ltomov/4-port-usb-hub/3d-view.png

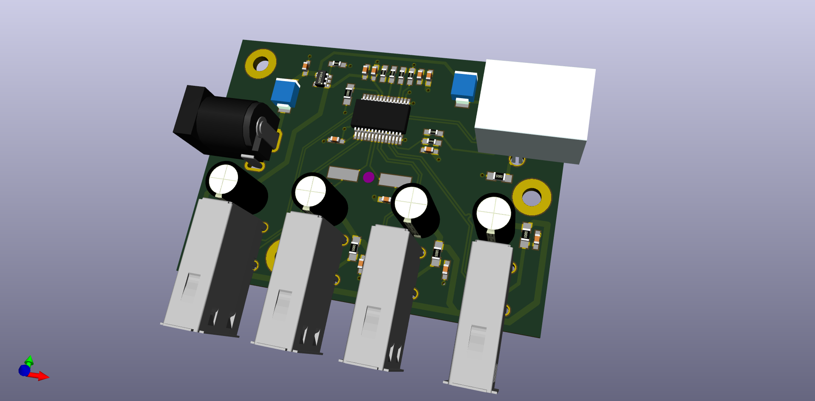
3d-view.png
