ltomov/4-port-usb-hub/4port-usb-hub.pdf

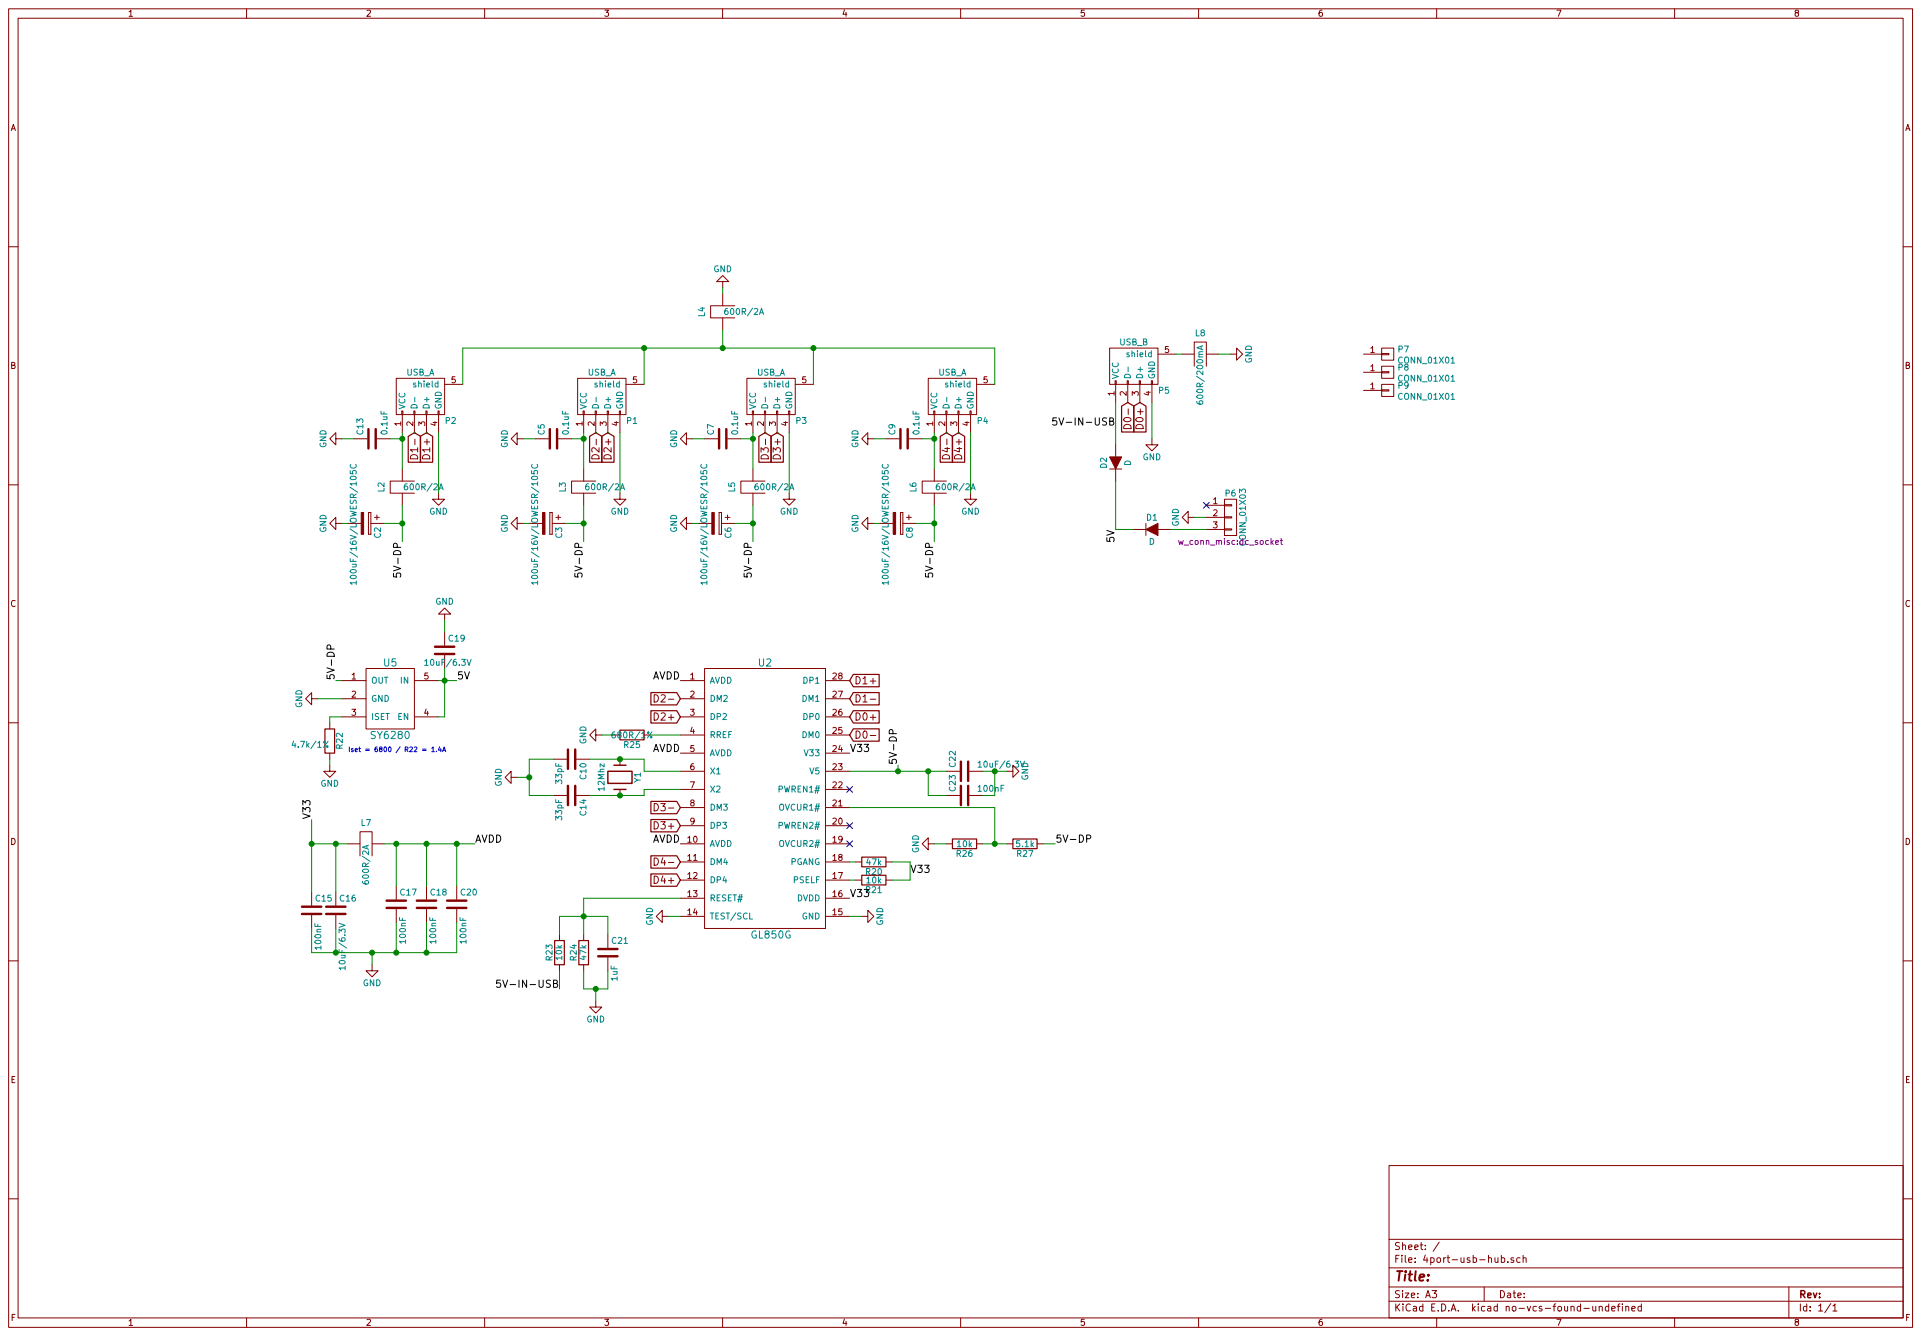
[picture p2: page 1]

3 GND
File: 4port-usb-hub.sch Sheet: / VCC
