ltomov/4-port-usb-hub/4port-usb-hub.kicad_pcb

## KiCad design 4port-usb-hub.kicad_pcb (2016-11-12)

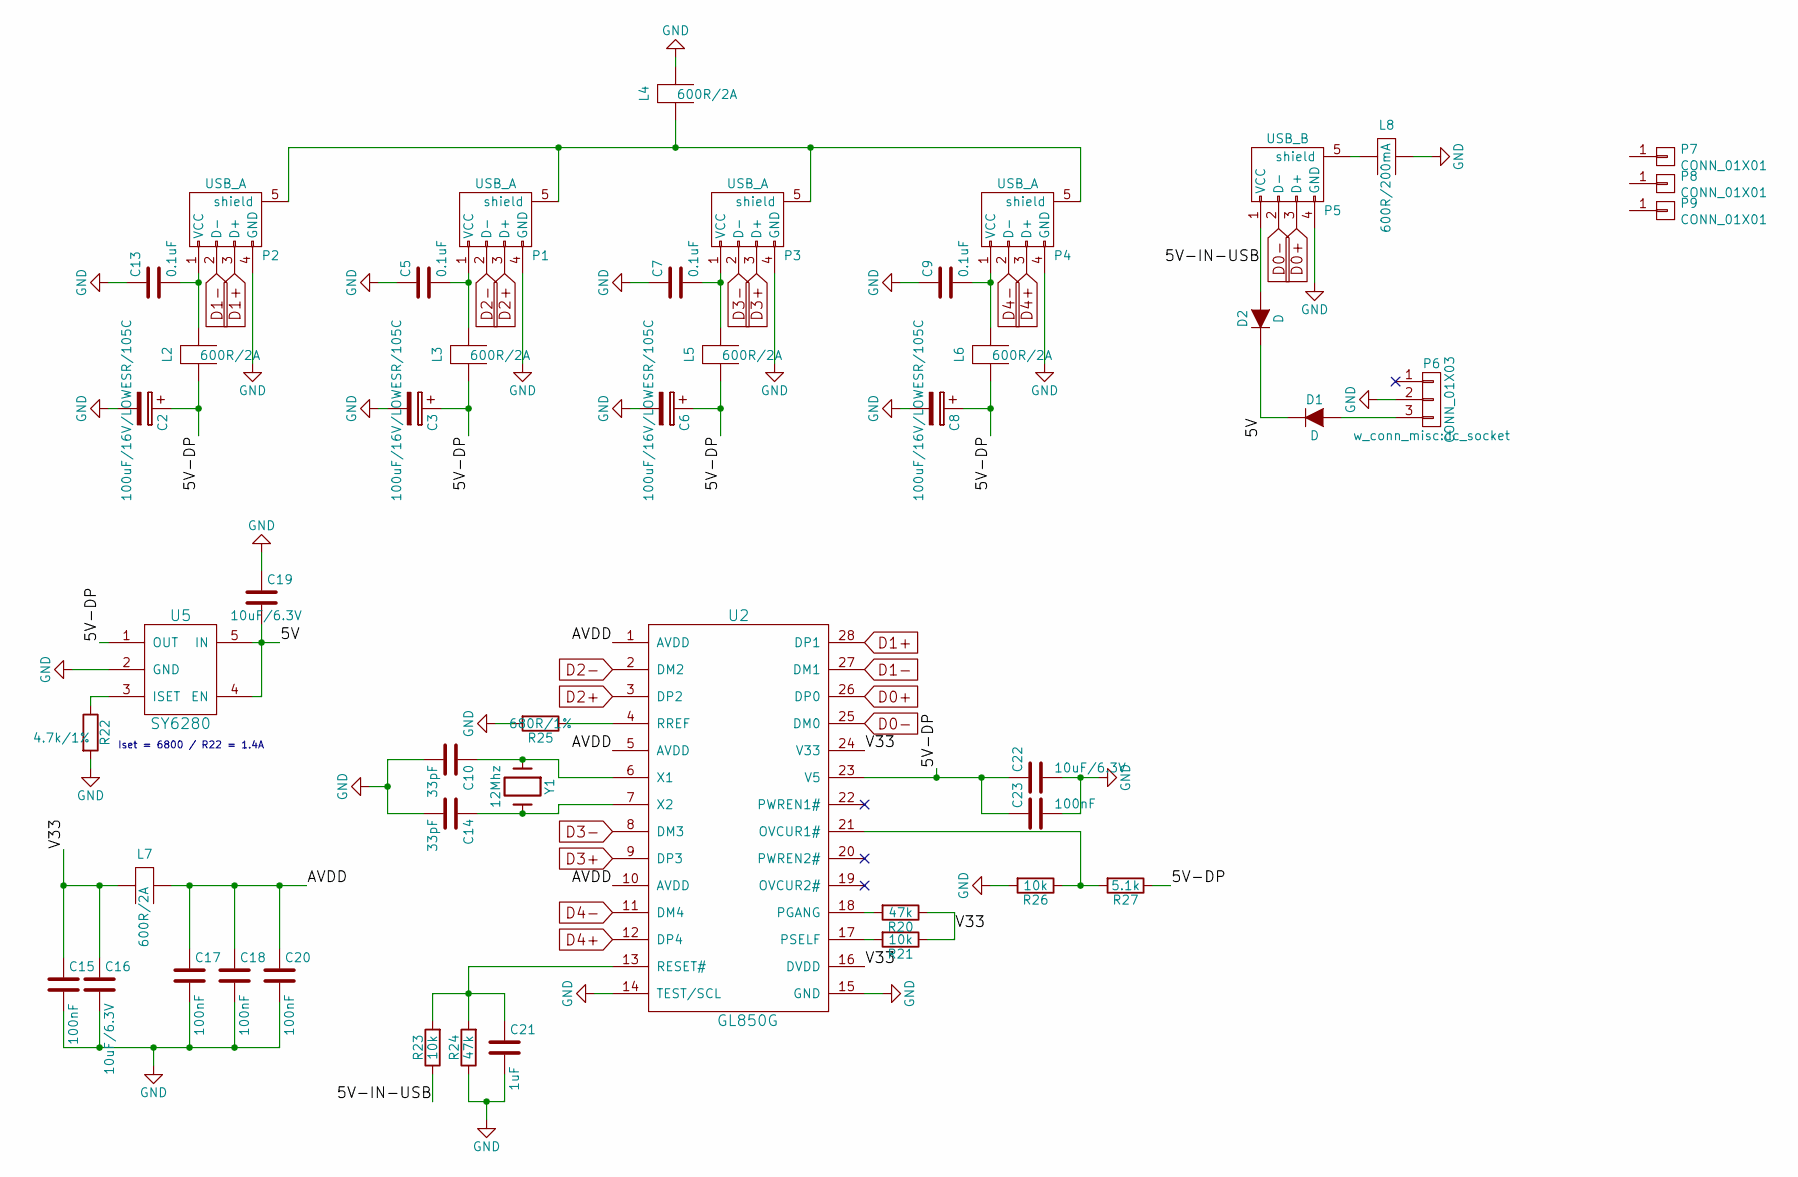
[picture p3: schematic 4port-usb-hub.sch]

Parts:
C2, C3, C6, C8: 100uF/16V/LOWESR/105C; C_Radial_D6.3_L11.2_P2.5
C5, C7, C9, C13: 0.1uF; C_0603_HandSoldering
C10, C14: 33pF; C_0603_HandSoldering
C15, C17, C18, C20, C23: 100nF; C_0603_HandSoldering
C16, C19, C22: 10uF/6.3V; C_0603_HandSoldering
C21: 1uF; C_0603_HandSoldering
D1, D2: D; SMB_Standard
L2, L3, L4, L5, L6, L7: 600R/2A; R_0805_HandSoldering
L8: 600R/200mA; R_0805_HandSoldering
P1, P2, P3, P4: USB_A; USB_A_Vertical
P5: USB_B
P6: CONN_01X03; dc_socket
P7, P8, P9: CONN_01X01; MountingHole_3.2mm_M3_Pad
R20, R24: 47k; R_0603_HandSoldering
R21, R23, R26: 10k; R_0603_HandSoldering
R22: 4.7k/1%; R_0603_HandSoldering
R25: 680R/1%; R_0603_HandSoldering
R27: 5.1k; R_0603_HandSoldering
U2: GL850G; SSOP-28_5.3x10.2mm_Pitch0.65mm
U5: SY6280; SOT-23-5
Y1: 12Mhz; Crystal_HC49-SD_SMD

Connections:
/5V: C19.2, D1.1 (K), D2.1 (K), U5.4 (EN), U5.5 (IN)
/5V-DP: C2.1, C3.1, C6.1, C8.1, C22.1, C23.1, L2.1, L3.1, L5.1, L6.1, R27.1, U2.23 (V5), U5.1 (OUT)
/5V-IN-USB: D2.2 (A), P5.1 (VCC), R23.1
/AVDD: C17.1, C18.1, C20.1, L7.2, U2.1 (AVDD), U2.5 (AVDD), U2.10 (AVDD)
/V33: C15.1, C16.1, L7.1, R20.1, R21.1, U2.16 (DVDD), U2.24 (V33)
D0+: P5.3 (D+), U2.26 (DP0)
D0-: P5.2 (D-), U2.25 (DM0)
D1+: P2.3 (D+), U2.28 (DP1)
D1-: P2.2 (D-), U2.27 (DM1)
D2+: P1.3 (D+), U2.3 (DP2)
D2-: P1.2 (D-), U2.2 (DM2)
D3+: P3.3 (D+), U2.9 (DP3)
D3-: P3.2 (D-), U2.8 (DM3)
D4+: P4.3 (D+), U2.12 (DP4)
D4-: P4.2 (D-), U2.11 (DM4)
GND: C2.2, C3.2, C5.1, C6.2, C7.1, C8.2, C9.1, C10.2, C13.1, C14.2, C15.2, C16.2, C17.2, C18.2, C19.1, C20.2, C21.2, C22.2, C23.2, L4.2, L8.2, P1.4 (GND), P2.4 (GND), P3.4 (GND), P4.4 (GND), P5.4 (GND), P6.2, R22.2, R24.1, R25.2, R26.2, U2.14 (TEST/SCL), U2.15 (GND), U5.2 (GND)
unnamed: C5.2, L3.2, P1.1 (VCC)
unnamed: C7.2, L5.2, P3.1 (VCC)
unnamed: C9.2, L6.2, P4.1 (VCC)
unnamed: C10.1, U2.6 (X1), Y1.1
unnamed: C13.2, L2.2, P2.1 (VCC)
unnamed: C14.1, U2.7 (X2), Y1.2
unnamed: C21.1, R23.2, R24.2, U2.13 (RESET#)
unnamed: D1.2 (A), P6.3
unnamed: L4.1, P1.5 (shield), P2.5 (shield), P3.5 (shield), P4.5 (shield)
unnamed: L8.1, P5.5 (shield)
unnamed: R20.2, U2.18 (PGANG)
unnamed: R21.2, U2.17 (PSELF)
unnamed: R22.1, U5.3 (ISET)
unnamed: R25.1, U2.4 (RREF)
unnamed: R26.1, R27.2, U2.21 (OVCUR1#)

Notes on the sheet:
Iset = 6800 / R22 = 1.4A

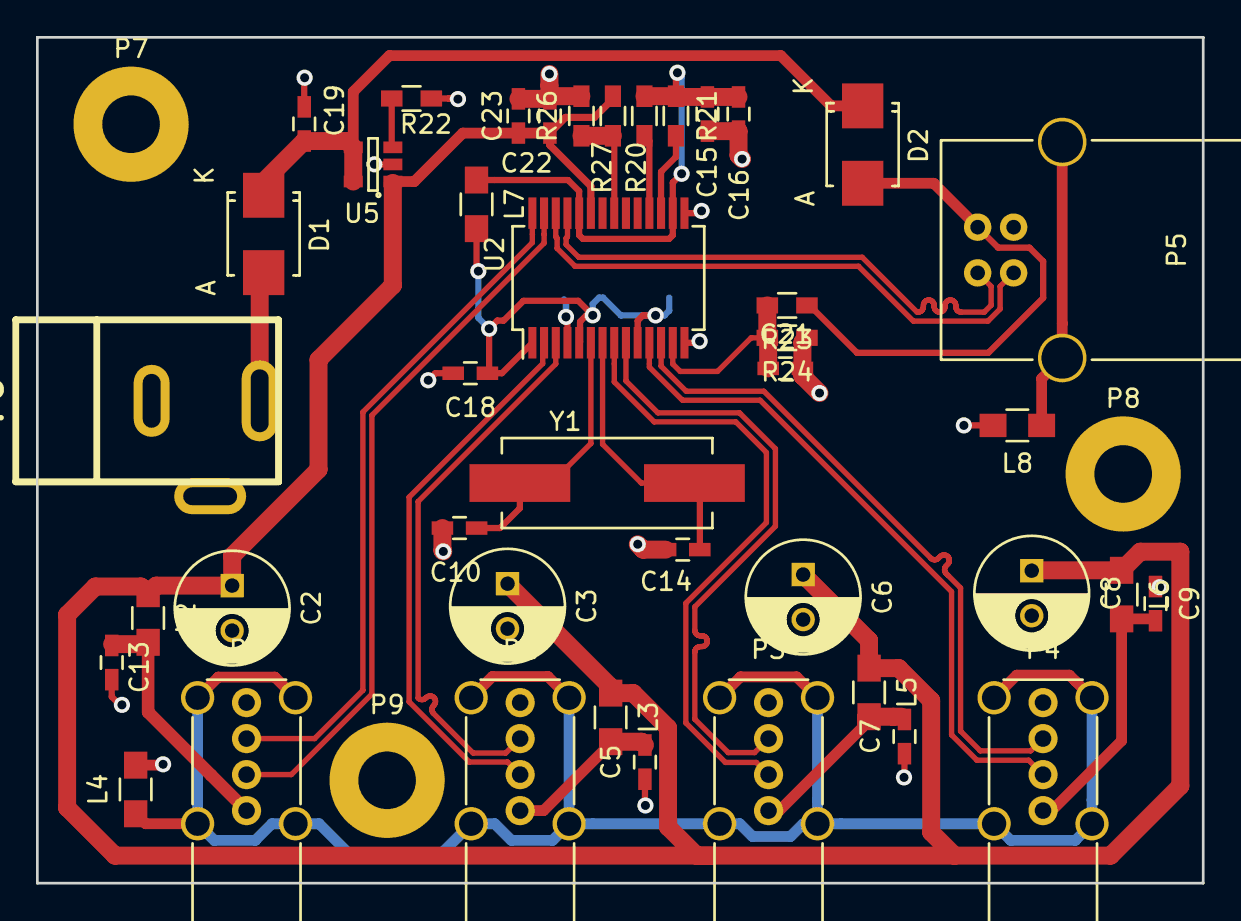
[picture p4: board 4port-usb-hub.kicad_pcb from above]

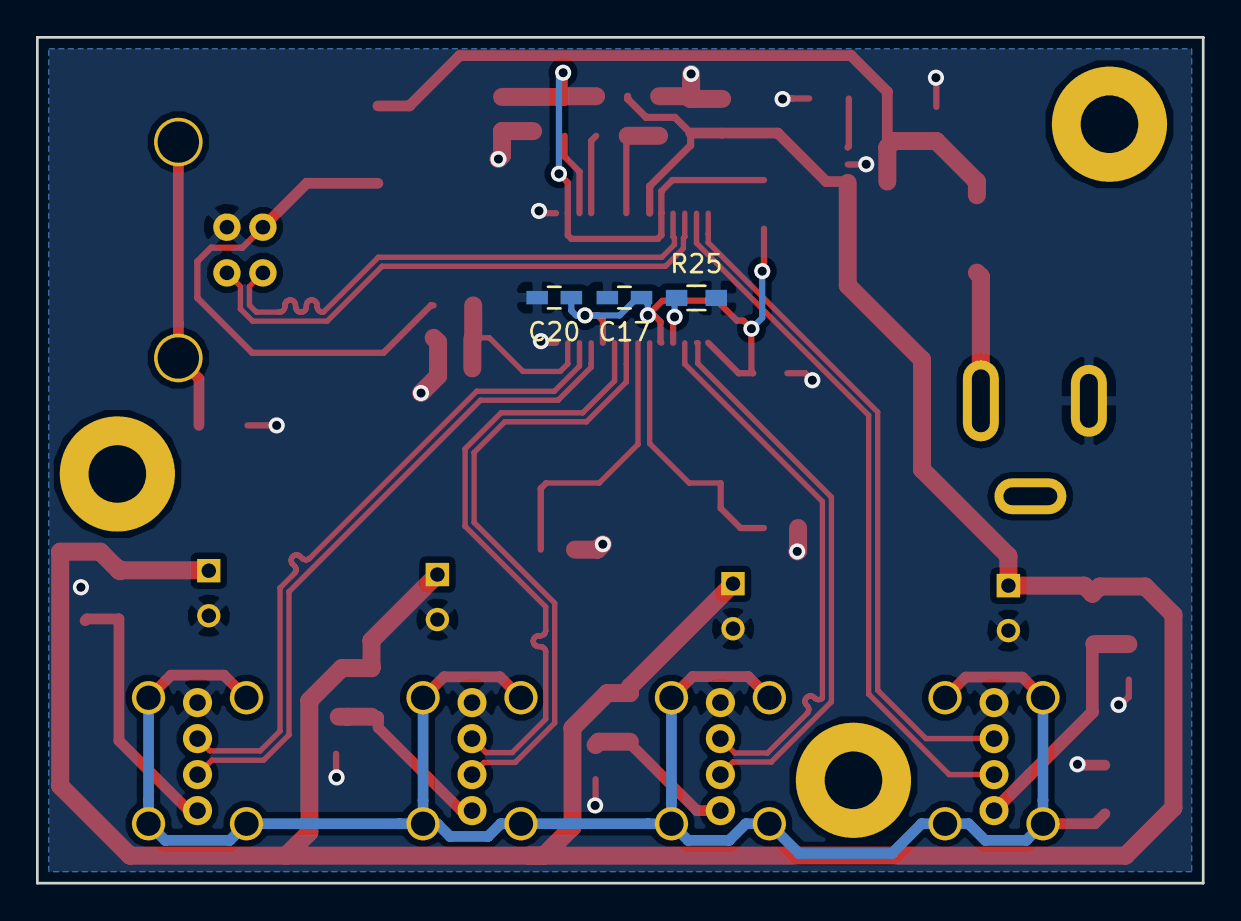
[picture p5: board 4port-usb-hub.kicad_pcb from below]

Board: 2 copper layers, 64.8 x 47.0 mm, 48 parts (3 on the bottom side), 31 nets.
